nex-finger/jikken3/README.md

<div align="center">
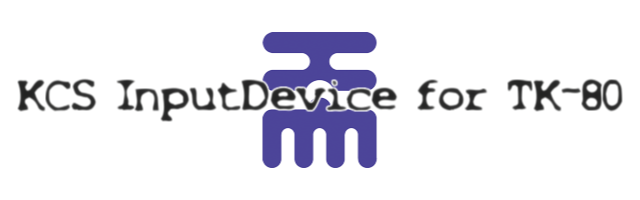
[picture p1: Image/readme-logo.png]
 
 <br>
 
 
 
 <br>
 
 
 
 <br>
 
 
 
 <br>

 <table>
  <tbody>
   <td align="center">
    <br>
    Status: <b>Unfinished</b><br>
    LatestUpdate: <b>2022/06/23</b><br>
    
    </td>
    </tbody>
  </table>
 </div>
 <br>
 
# 概要
 
 情報工学実験3の資料置き場<br>
 Kansas City Standard (KCS) を用いたデータの解釈，解釈したデータのZK-80(TK-80互換機)への入力を実現する<br>

# リポジトリ説明
 
 * Document: 毎回まとめたpdfを貼ります
 * Image   : 画像をはります，写真もノートのスキャンもこちらです
 * other   : その他の雑多なもの
 * Program : プログラムコードをこちらに
 
# 参考文献
 
 インターネットに蔓延る情報を提供します<br>
 
 * 💻 ハードウェア関連
 >[TK-80 仕様](http://star.gmobb.jp/koji/cgi/wiki.cgi?page=TK%2D80%BB%F1%CE%C1%A5%E1%A5%E2 "タイトル")
 >
 >[ZK-80について](https://www.recfor.net/blog/mycom/?itemid=883 "タイトル")
 <br>
 
 * 💾 ソフトウェア関連
 >[8080機械語命令表](http://tyunitidenko.x0.com/nd3setumeisyo/nd3_8080meirei.pdf "タイトル")
 >
 >[8080機械語対照表](https://qiita.com/tetr4lab/items/9cdf66144031f149638e "タイトル")
 >
 >[ZK-80 モニタプログラム](http://tyunitidenko.x0.com/nd3setumeisyo/nd3_tk80monitor.pdf "タイトル")

 * 🔋 部品データ
 >[Arduino uno](https://akizukidenshi.com/catalog/g/gM-07385/ "タイトル")
 >
 >[4bitデコーダマルチプレクサ 74159](https://html.alldatasheet.com/html-pdf/27375/TI/74159/19/1/74159.html "タイトル")
 >
 >[フォトカプラ TLP592A](https://toshiba.semicon-storage.com/jp/semiconductor/product/isolators-solid-state-relays/photorelay-mosfet-output/detail.TLP592A.html "タイトル")
 >
 >[コンパレータ NJM2903D](https://akizukidenshi.com/catalog/g/gI-13486/ "タイトル")
 >https://www.youtube.com/watch?v=rtqjt72nOPw
 <br>
