nex-finger/jikken3/Image/decode1.png

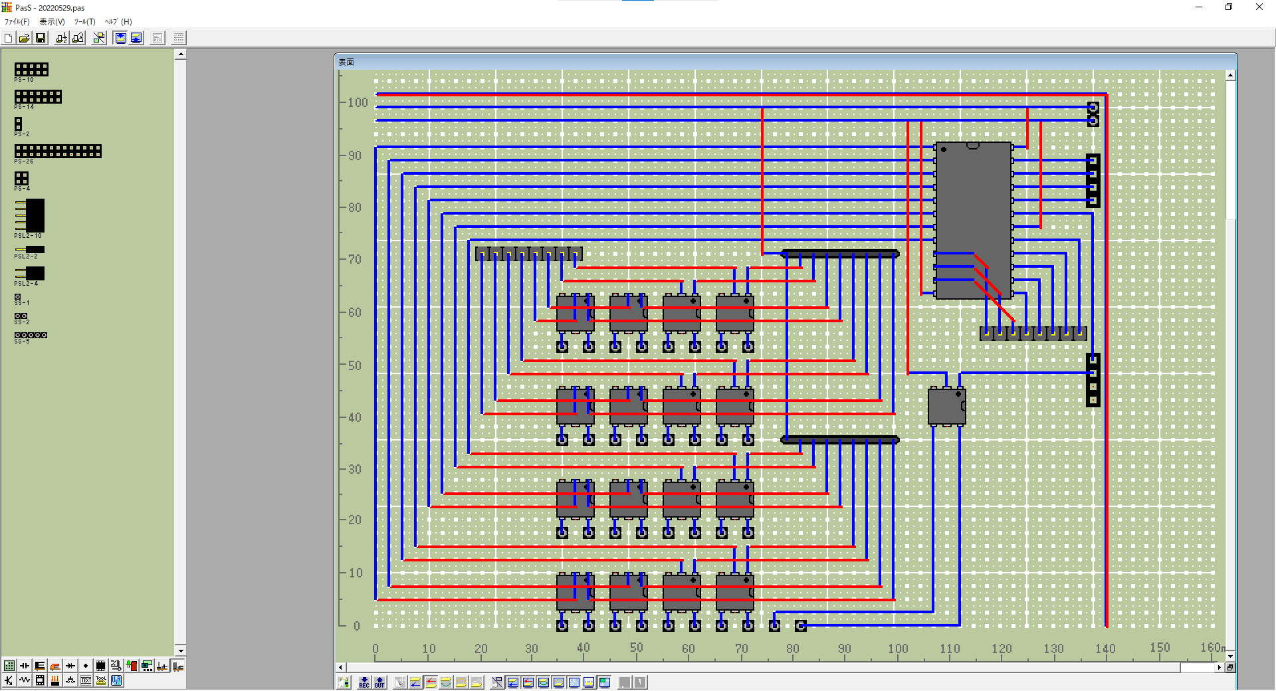
Image/decode1.png
