nex-finger/jikken3/Image/decode2.png

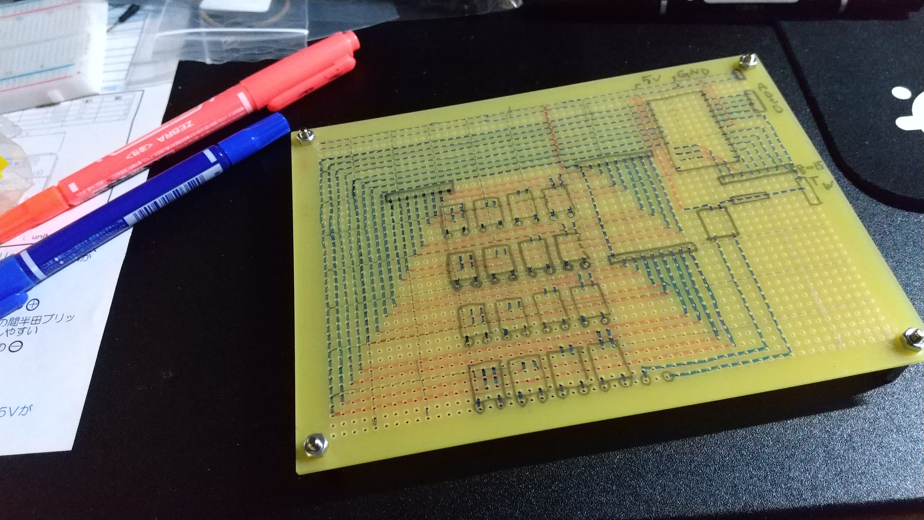
Image/decode2.png
