nex-finger/jikken3/Image/decode3.png

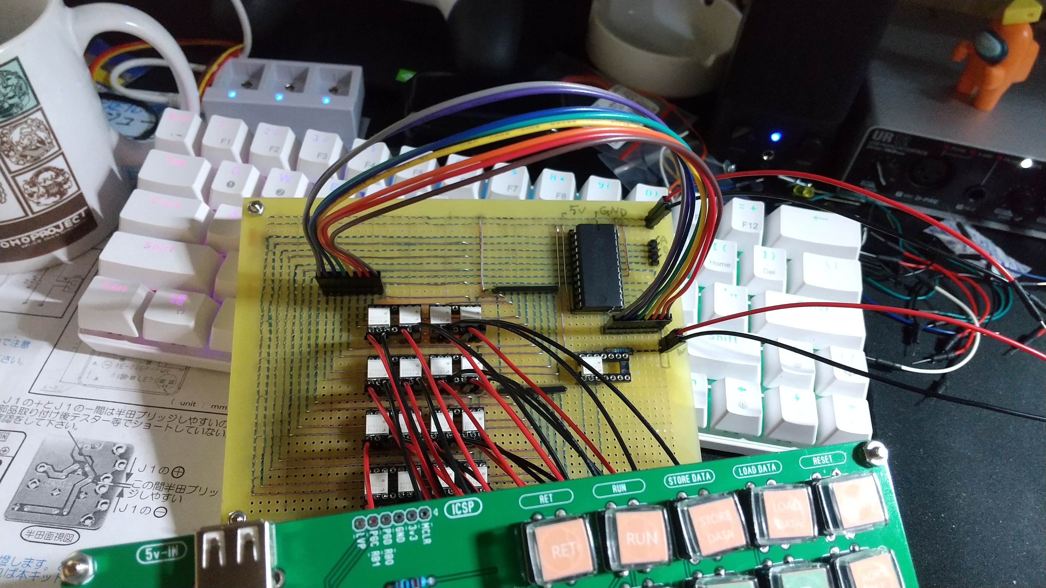
Image/decode3.png
