nex-finger/jikken3/Image/drow.drowio.drawio.png

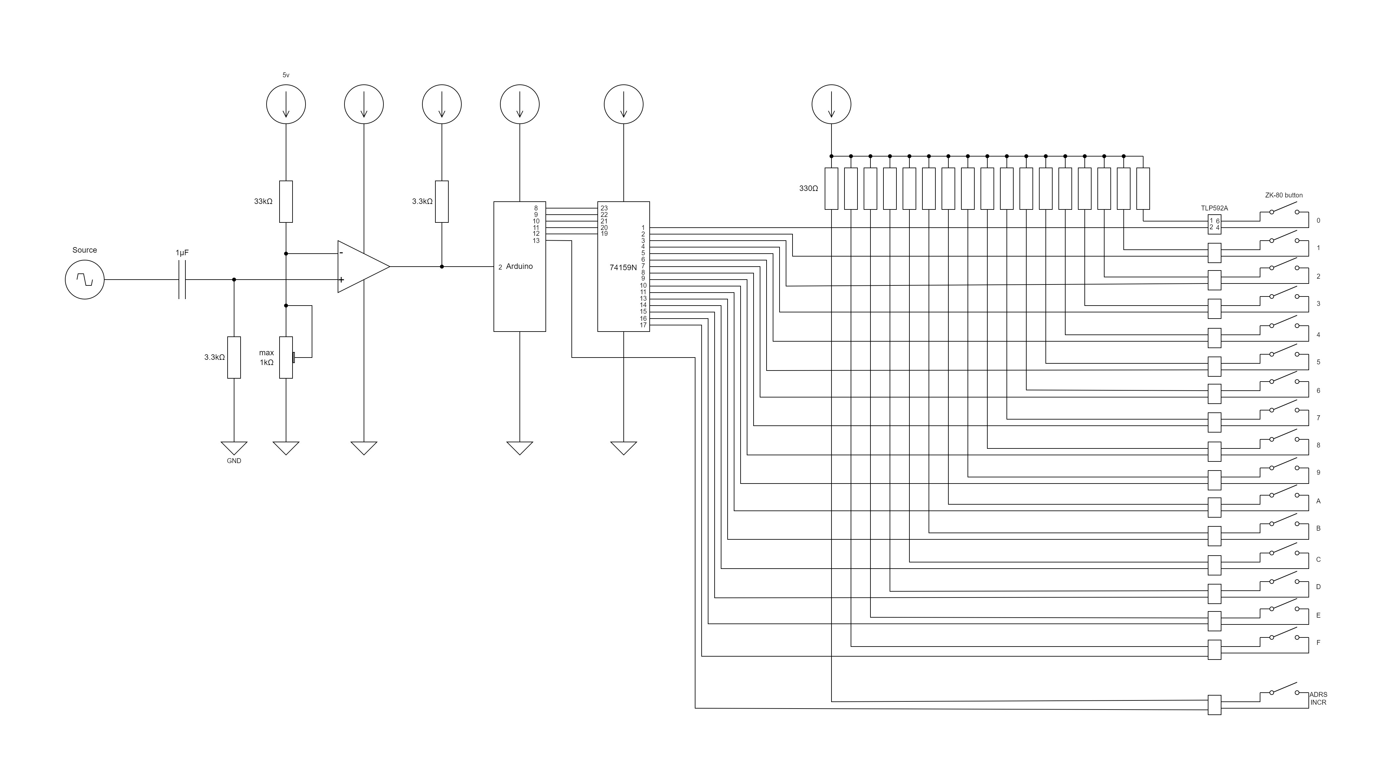
Image/drow.drowio.drawio.png
