nex-finger/jikken3/Image/flowchart.png

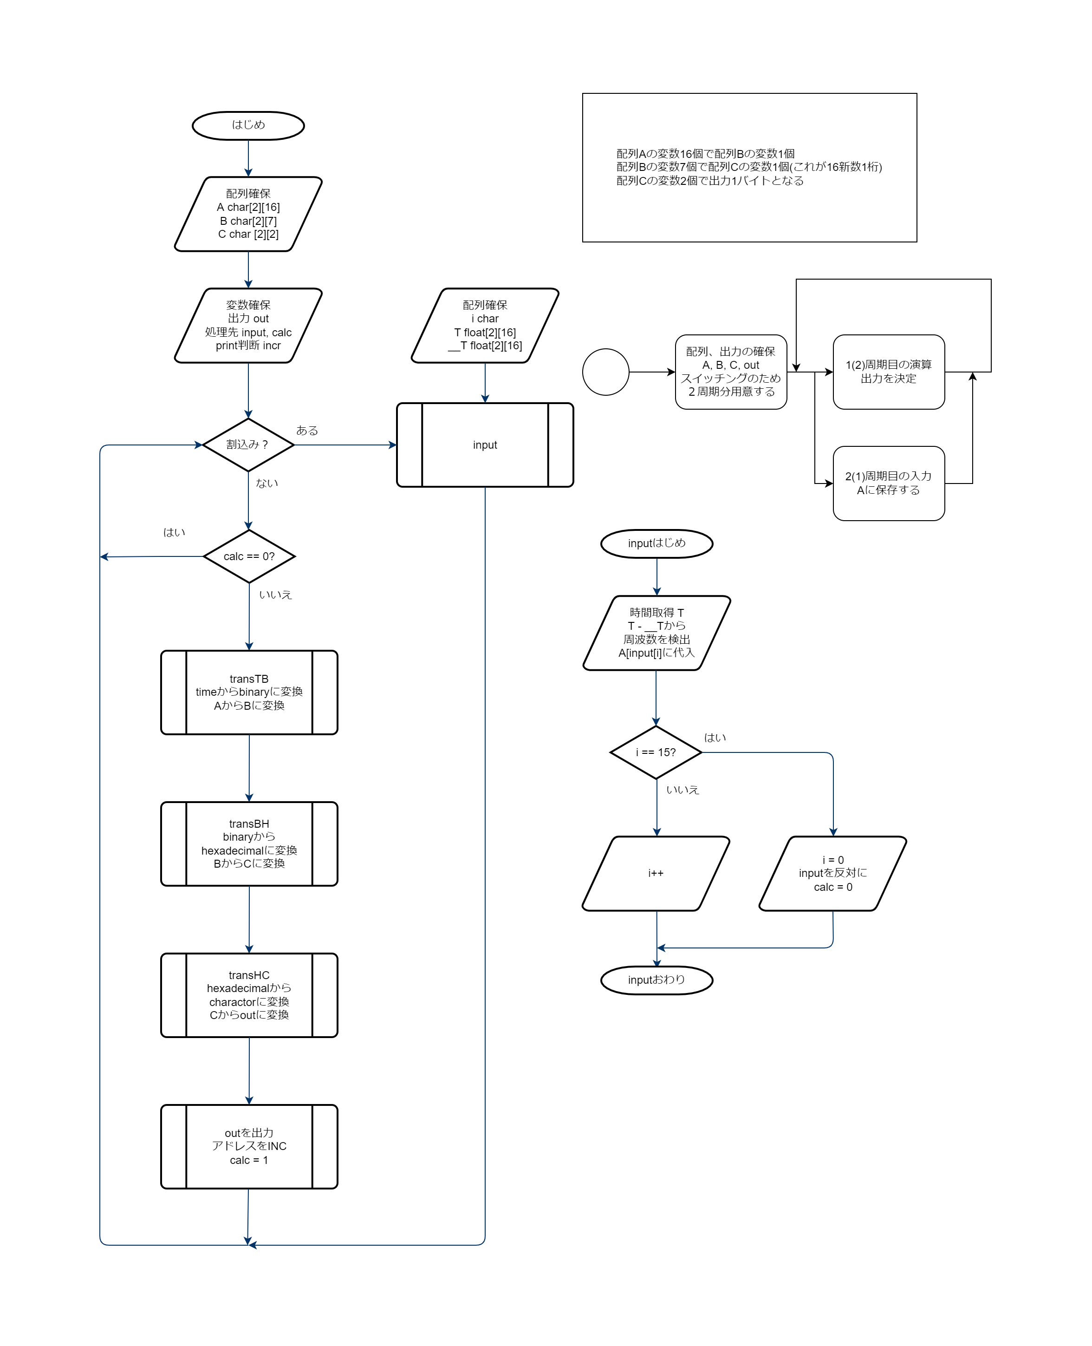
Image/flowchart.png
