nex-finger/jikken3/Image/furo-.png

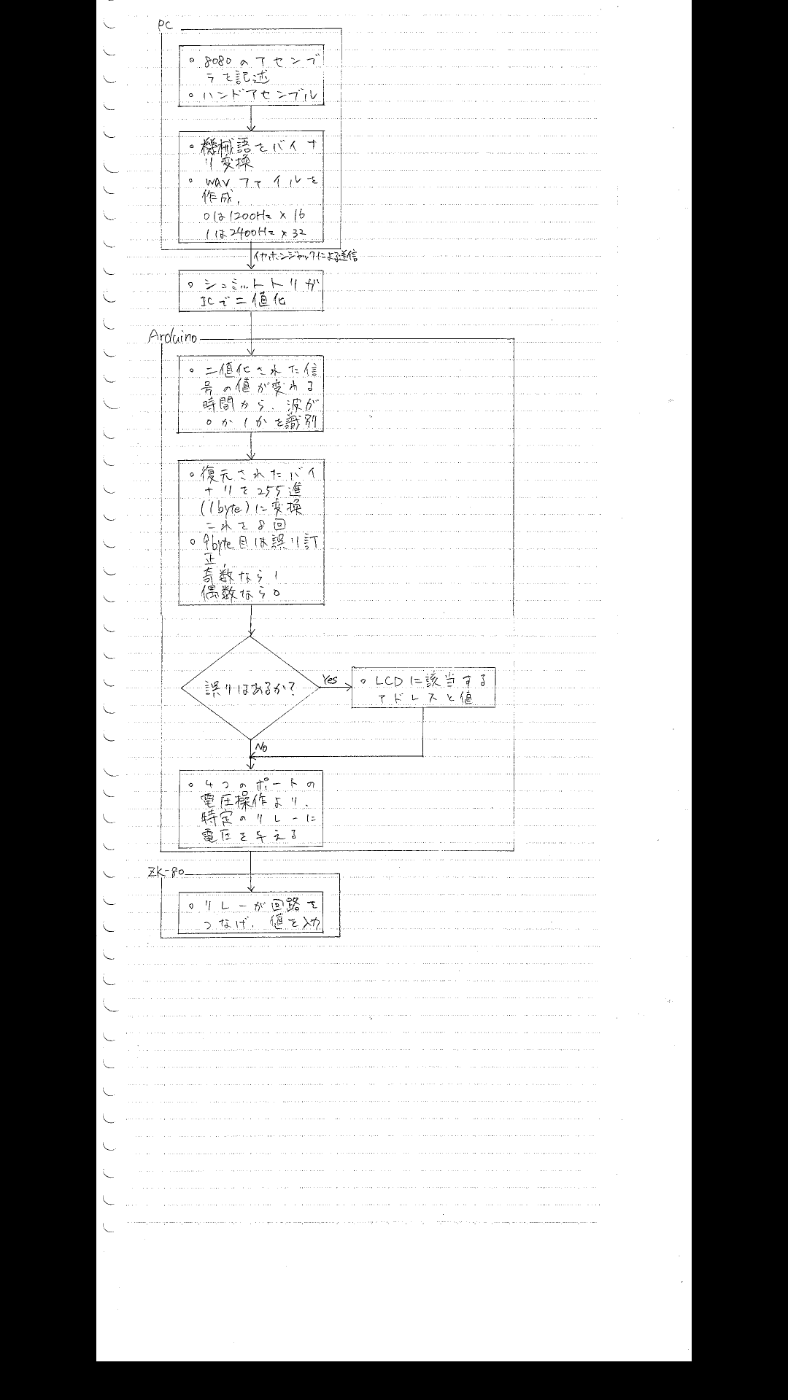
Image/furo-.png
