nex-finger/jikken3/Image/inputkairo.jpg

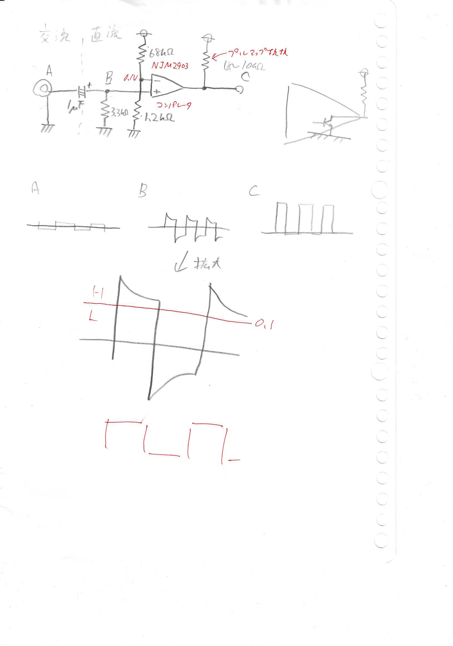
Image/inputkairo.jpg
