nex-finger/jikken3/Image/kairo.png

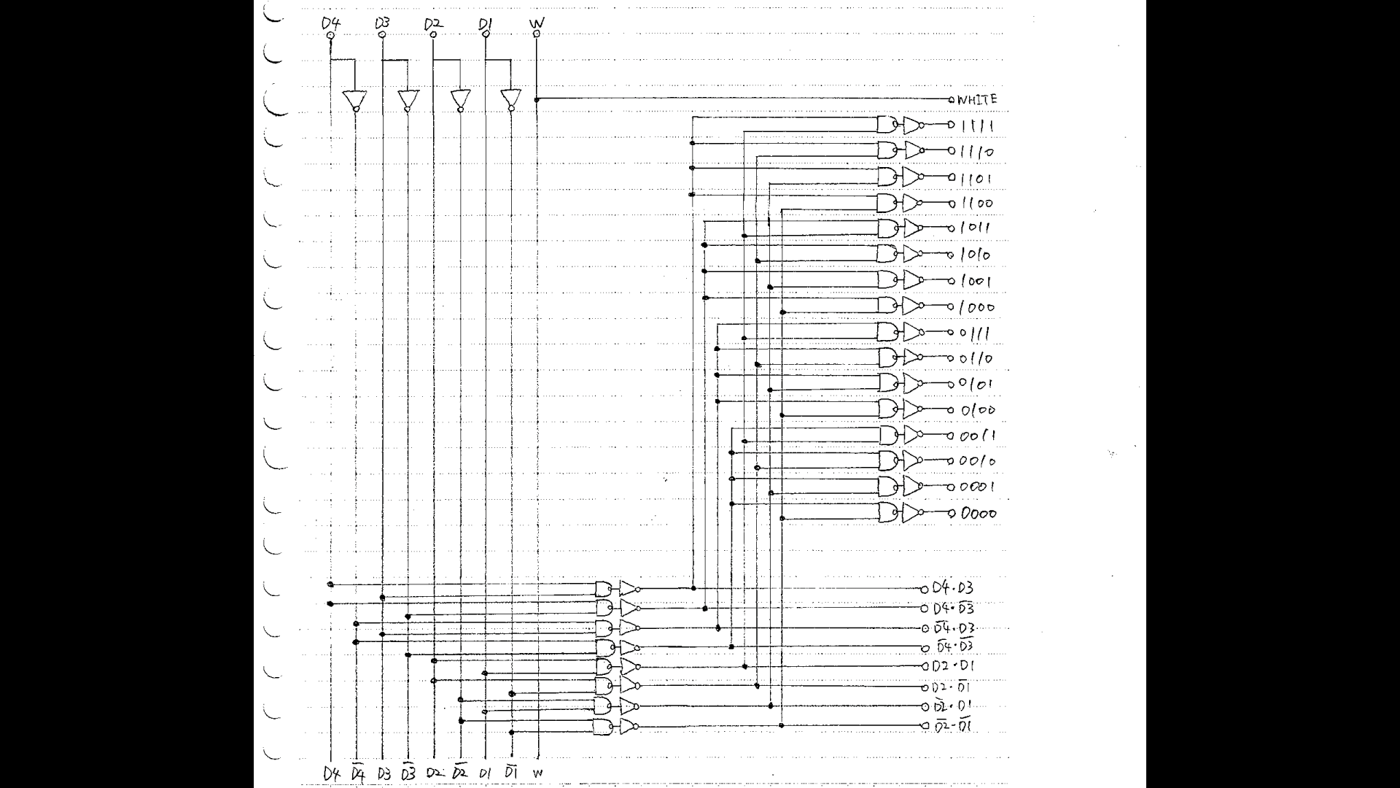
Image/kairo.png
