nex-finger/jikken3/Image/mudajane.png

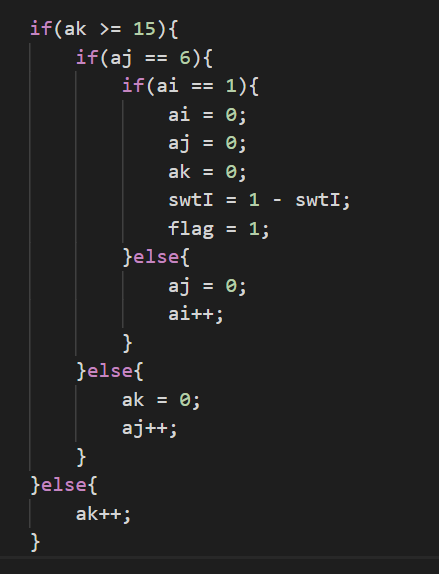
Image/mudajane.png
