nex-finger/jikken3/Image/osiro1.png

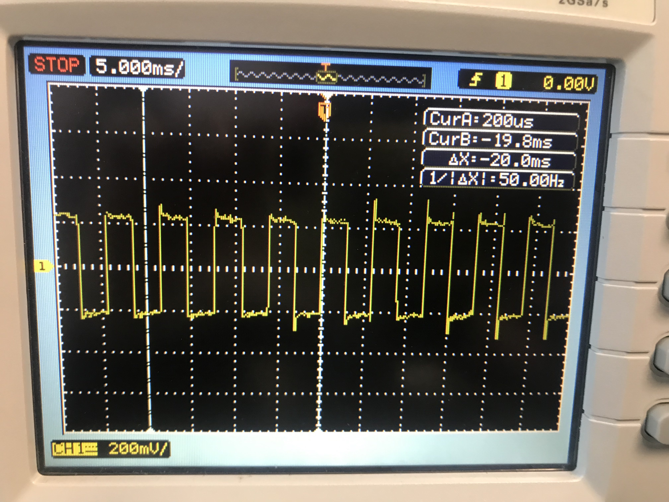
Image/osiro1.png
