nex-finger/jikken3/Image/osiro2.png

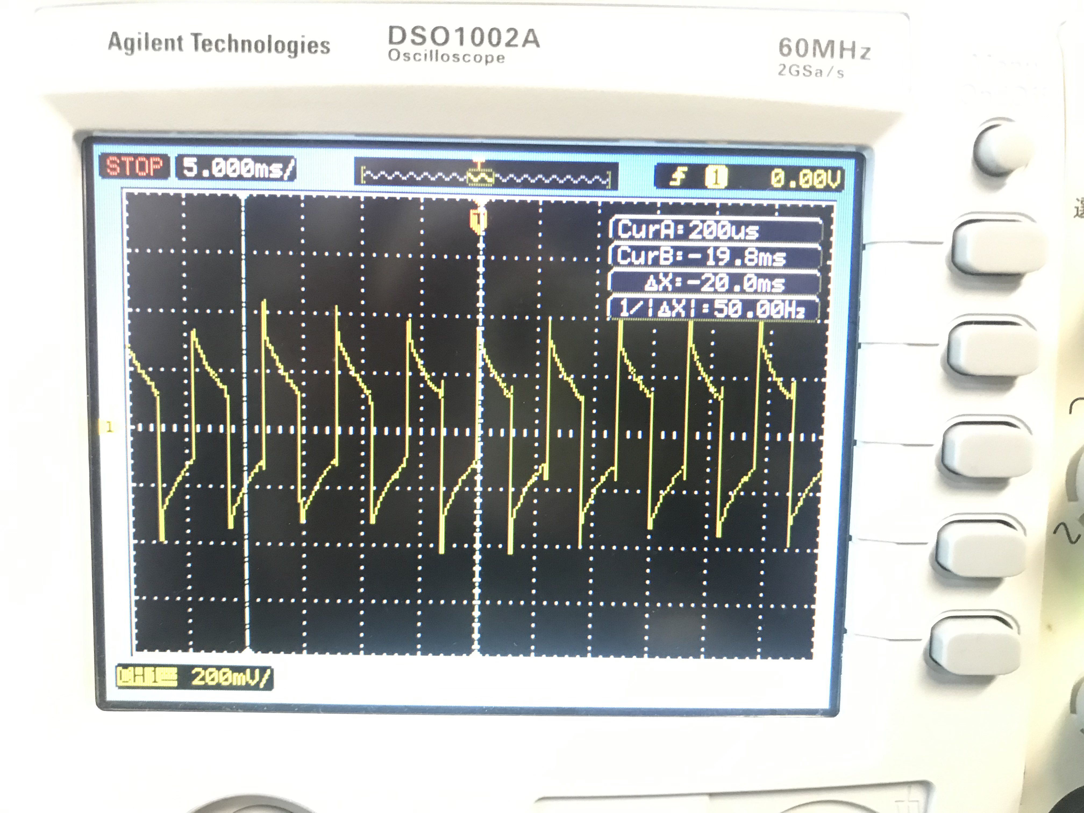
Image/osiro2.png
