nex-finger/jikken3/(notices)

Notices in the files:
README.md:
License: masuda
